WysokinskiWojciech/Praca_Inzynierska/PerformanceLog.txt

Number of Contacts: 8
Number of contact data: 1271
