WysokinskiWojciech/Praca_Inzynierska/Złożenie6.sldasm

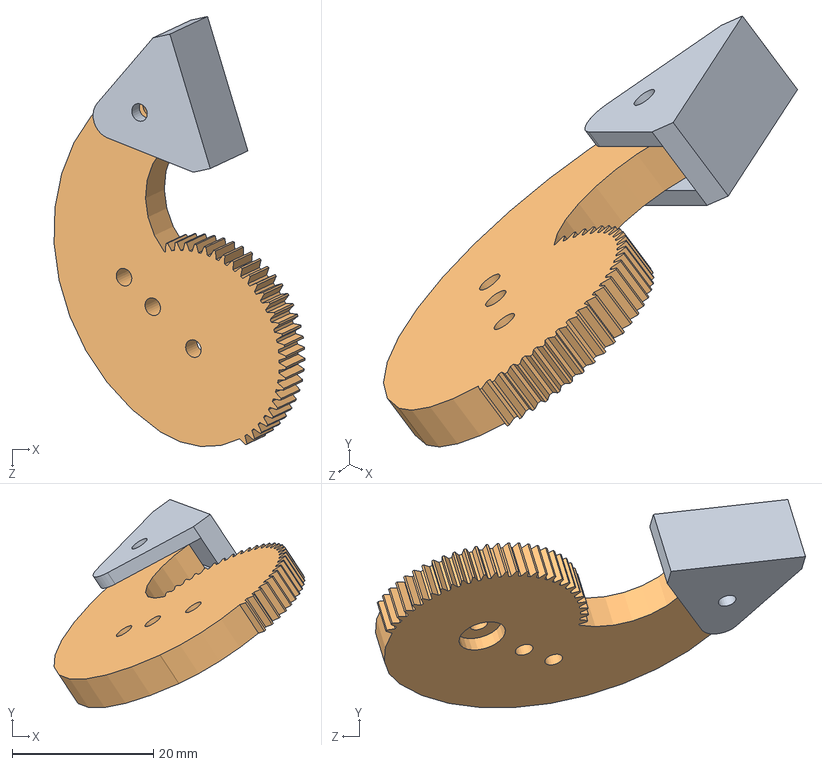
[picture p48: CAD file, 2021-02-26]
Złożenie6.sldasm
35.5 x 29.5 x 60.9 mm
Chwyt
koło_zębate
