WysokinskiWojciech/Praca_Inzynierska/Złożenie7.sldasm

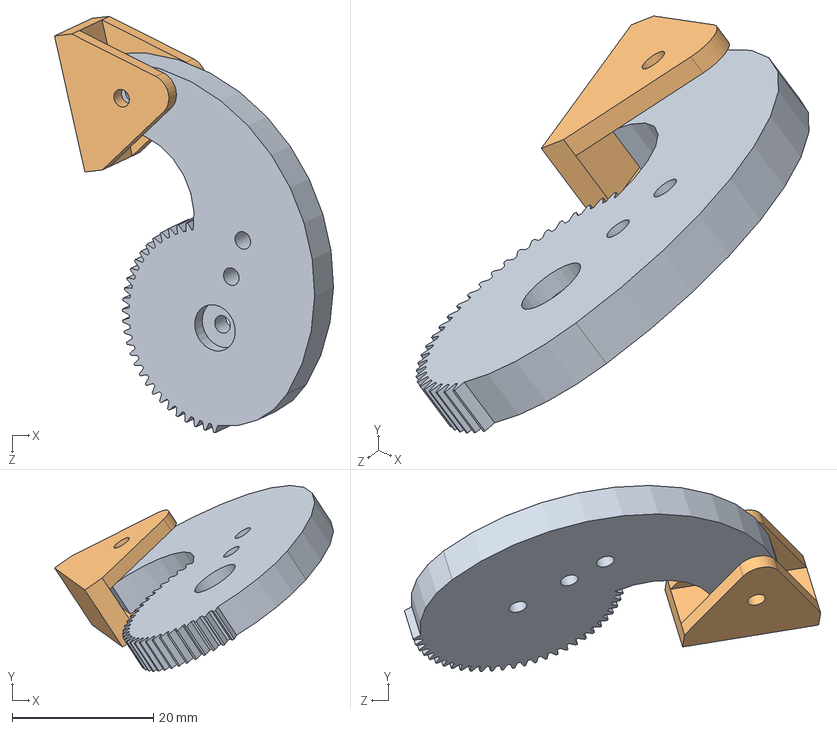
[picture p49: CAD file, 2021-02-26]
Złożenie7.sldasm
39.5 x 26.4 x 59.0 mm
Chwyt
koło_zębate
