WysokinskiWojciech/Praca_Inzynierska/Złożenie3.sldasm

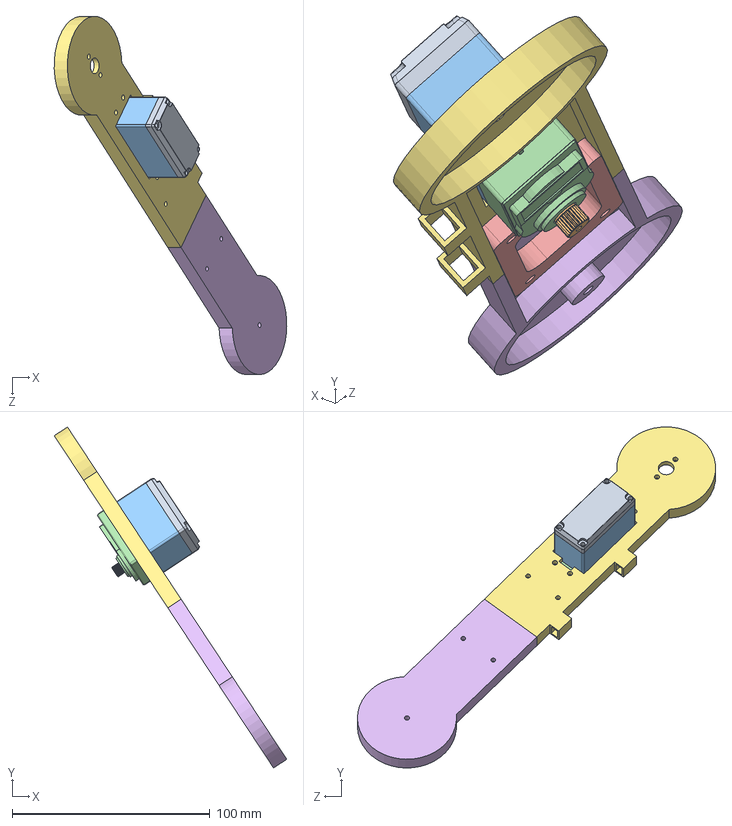
[picture p50: CAD file, 2021-02-26]
Złożenie3.sldasm
117.5 x 172.2 x 180.9 mm
Base
Eje
Medio
plytka
ramie1
ramie
