WysokinskiWojciech/Praca_Inzynierska/Złożenie4.sldasm

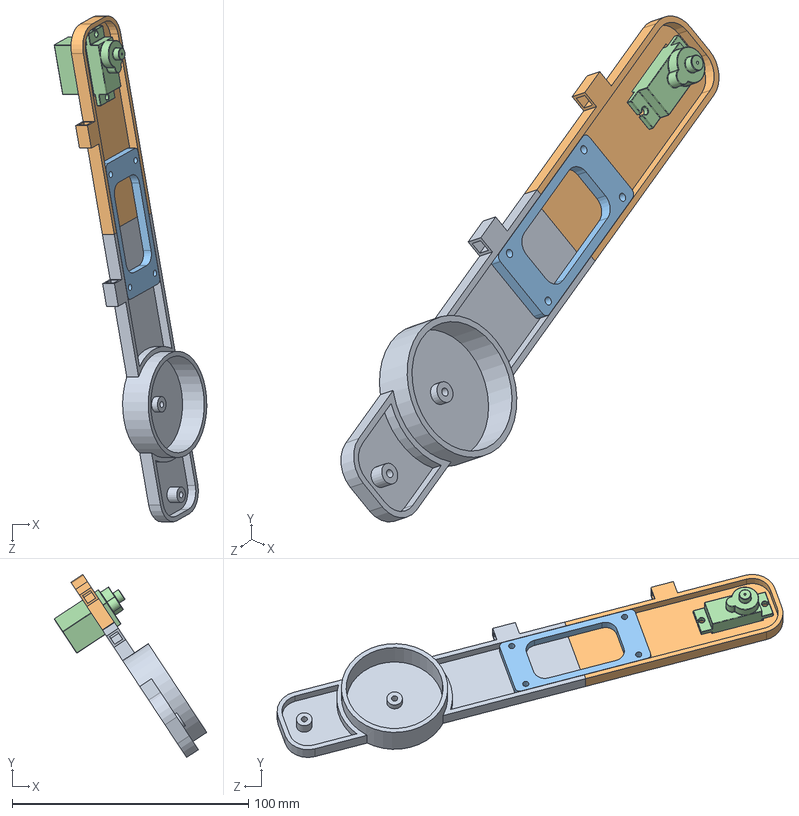
[picture p51: CAD file, 2021-02-26]
Złożenie4.sldasm
64.6 x 77.4 x 213.9 mm
ramie2
ramie21
plytka2
