WysokinskiWojciech/Praca_Inzynierska/Złożenie8.sldasm

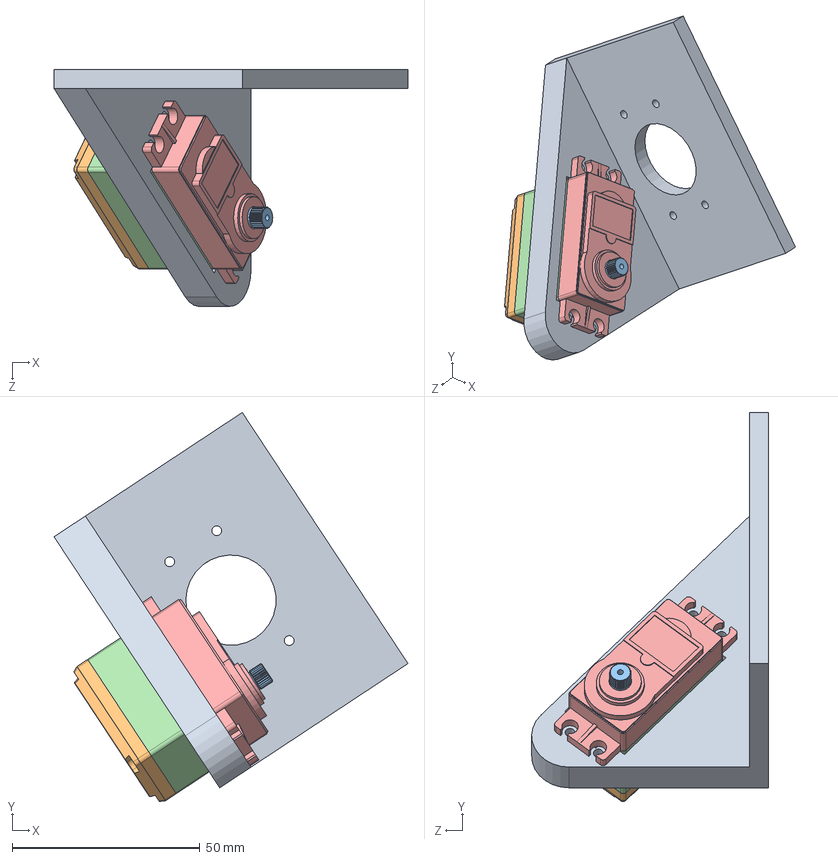
[picture p52: CAD file, 2021-02-26]
Złożenie8.sldasm
94.1 x 103.5 x 63.0 mm
Mocowanie
Base
Eje
Medio
Top
