WysokinskiWojciech/Praca_Inzynierska/MG_996R.SLDASM

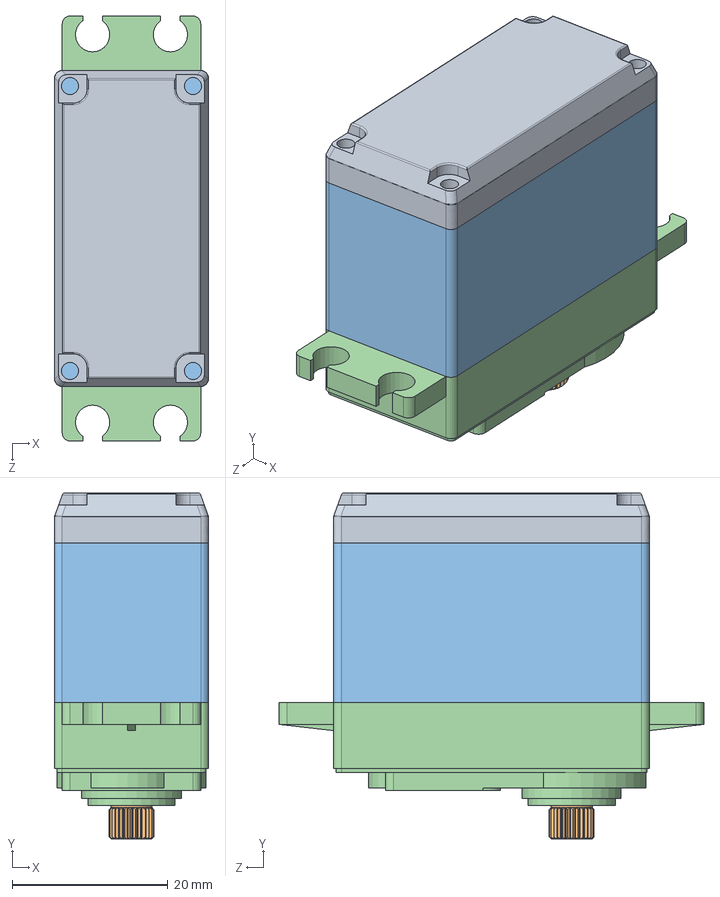
[picture p53: CAD file, 2021-02-26]
MG_996R.SLDASM
19.8 x 44.4 x 54.6 mm
Base
Eje
Medio
Top
