WysokinskiWojciech/Praca_Inzynierska/4 Arm.SLDPRT

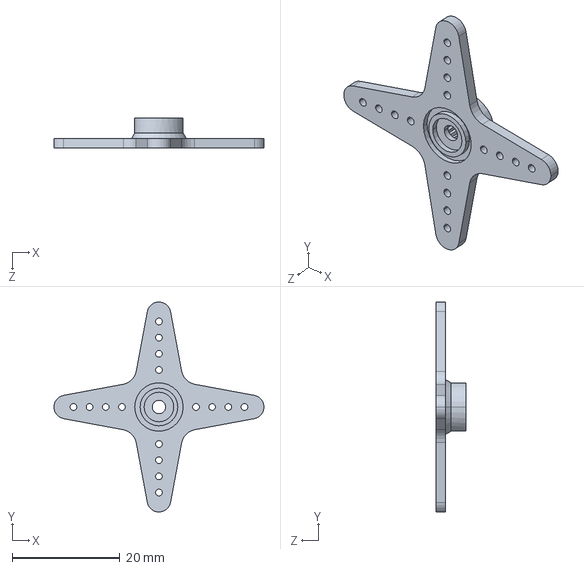
[picture p54: CAD file, 2021-02-26]
4 Arm.SLDPRT
39.0 x 39.0 x 5.50 mm
