WysokinskiWojciech/Praca_Inzynierska/łacznik.SLDPRT

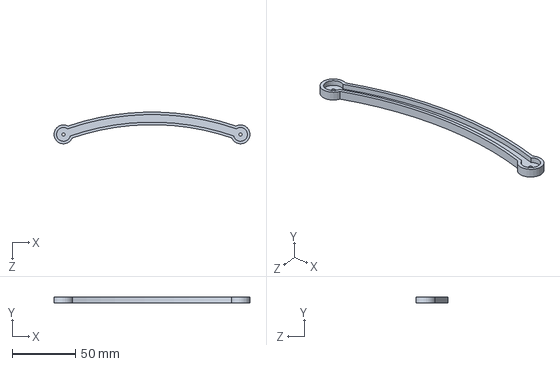
[picture p55: CAD file, 2021-02-26]
łacznik.SLDPRT
155.0 x 5.00 x 25.0 mm
