WysokinskiWojciech/Praca_Inzynierska/Dekiel.SLDPRT

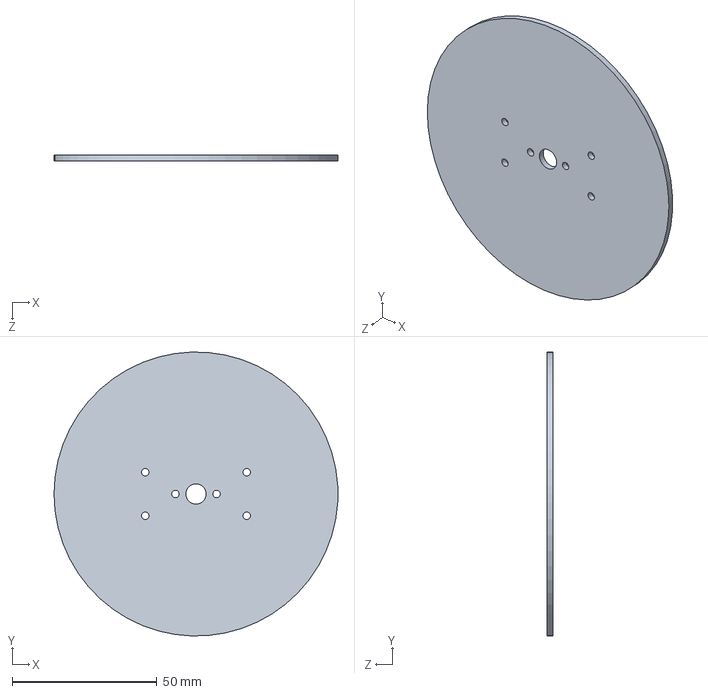
[picture p56: CAD file, 2021-02-26]
Dekiel.SLDPRT
98.0 x 98.0 x 2.00 mm
