WysokinskiWojciech/Praca_Inzynierska/Eje.SLDPRT

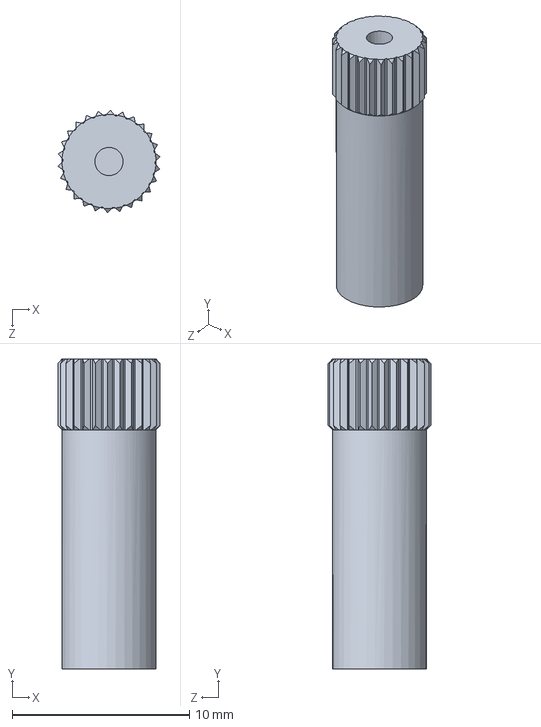
[picture p57: CAD file, 2021-02-26]
Eje.SLDPRT
5.78 x 17.5 x 5.80 mm
