WysokinskiWojciech/Praca_Inzynierska/ramie2.SLDPRT

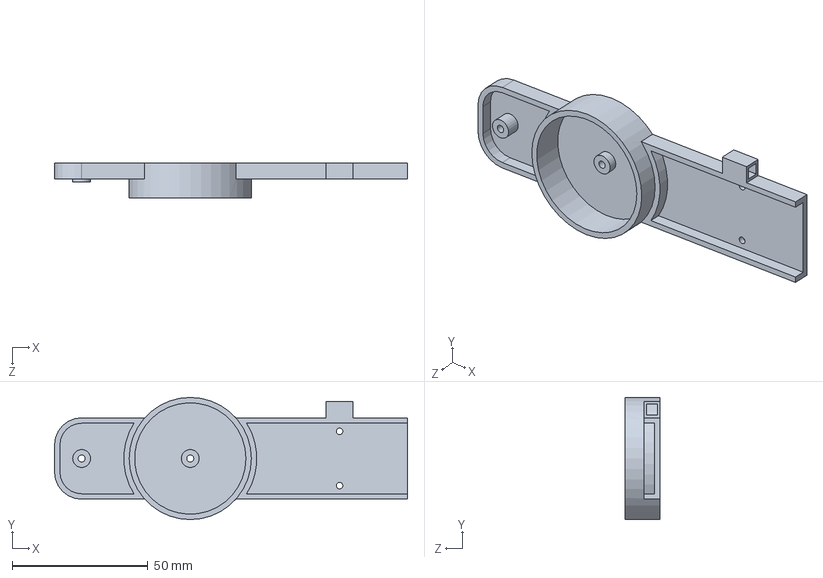
[picture p58: CAD file, 2021-02-26]
ramie2.SLDPRT
130.0 x 45.0 x 13.0 mm
