WysokinskiWojciech/Praca_Inzynierska/ramie21.SLDPRT

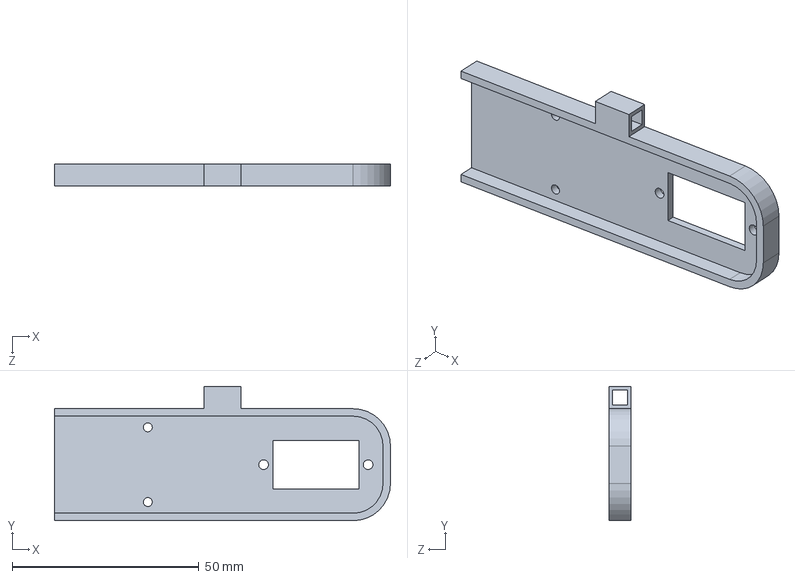
[picture p59: CAD file, 2021-02-26]
ramie21.SLDPRT
90.0 x 36.0 x 6.00 mm
