WysokinskiWojciech/Praca_Inzynierska/podstawa.SLDPRT

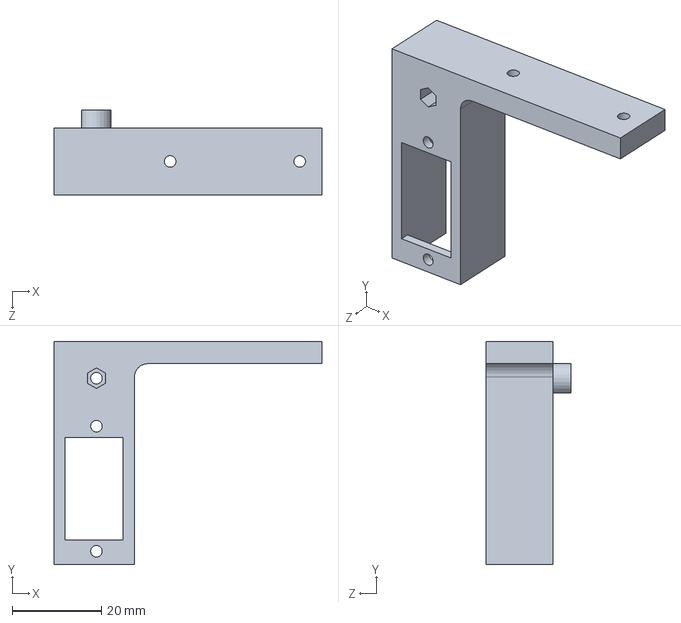
[picture p60: CAD file, 2021-02-26]
podstawa.SLDPRT
60.0 x 50.0 x 19.0 mm
