WysokinskiWojciech/Praca_Inzynierska/111.SLDPRT

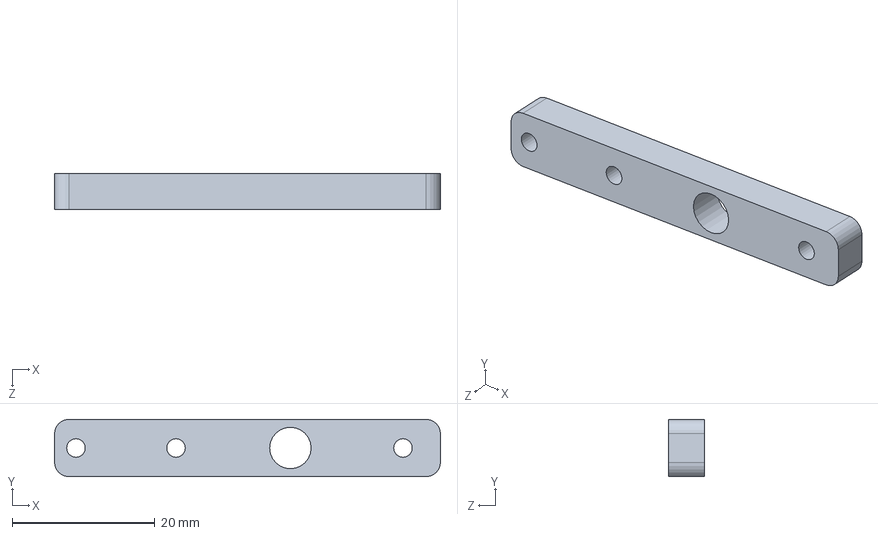
[picture p61: CAD file, 2021-02-26]
111.SLDPRT
54.0 x 8.00 x 5.00 mm
