WysokinskiWojciech/Praca_Inzynierska/msh1.SLDPRT

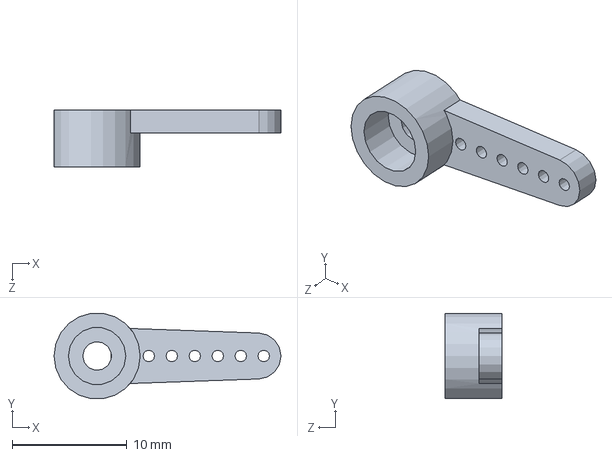
[picture p62: CAD file, 2021-02-26]
msh1.SLDPRT
19.8 x 7.42 x 5.00 mm
