WysokinskiWojciech/Praca_Inzynierska/Chwyt.SLDPRT

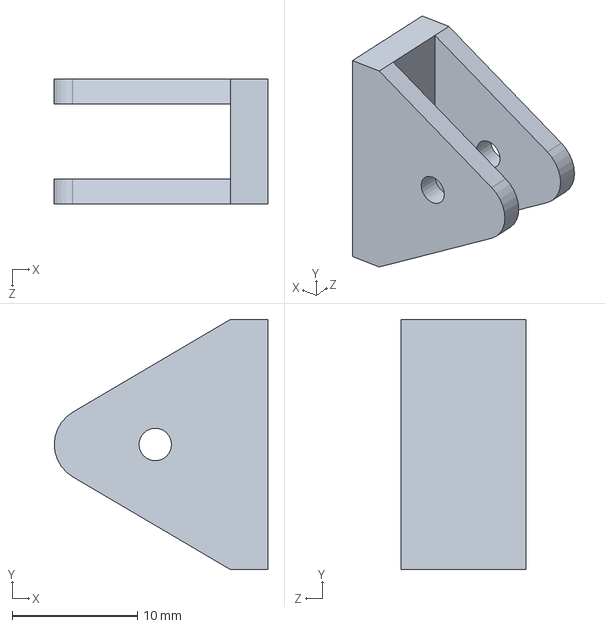
[picture p63: CAD file, 2021-02-26]
Chwyt.SLDPRT
17.1 x 20.0 x 10.0 mm
