WysokinskiWojciech/Praca_Inzynierska/ramie.SLDPRT

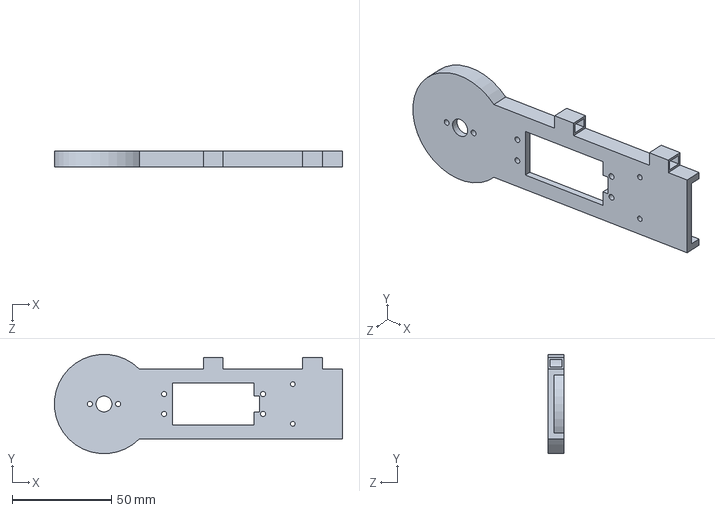
[picture p64: CAD file, 2021-02-26]
ramie.SLDPRT
144.9 x 49.8 x 8.00 mm
