WysokinskiWojciech/Praca_Inzynierska/Top.SLDPRT

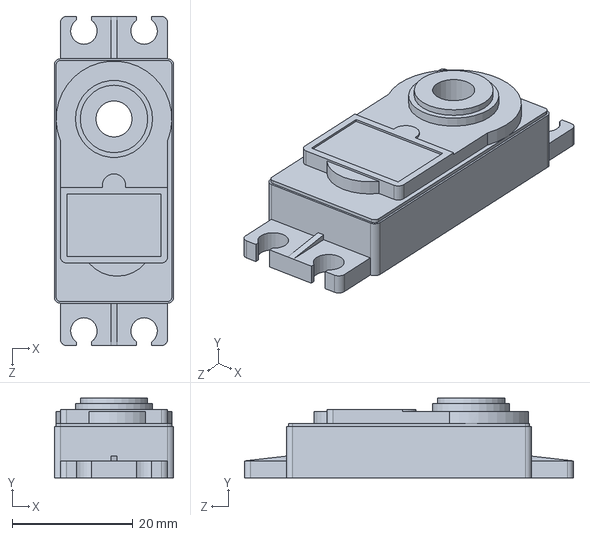
[picture p65: CAD file, 2021-02-26]
Top.SLDPRT
19.8 x 13.2 x 54.6 mm
