WysokinskiWojciech/Praca_Inzynierska/koło_zębate.SLDPRT

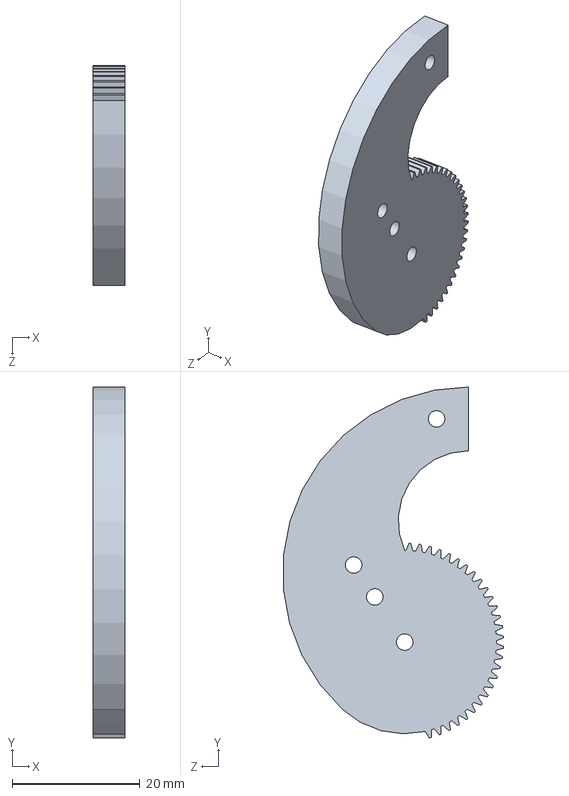
[picture p66: CAD file, 2021-02-26]
koło_zębate.SLDPRT
5.00 x 55.0 x 34.5 mm
