WysokinskiWojciech/Praca_Inzynierska/Orczyk.SLDPRT

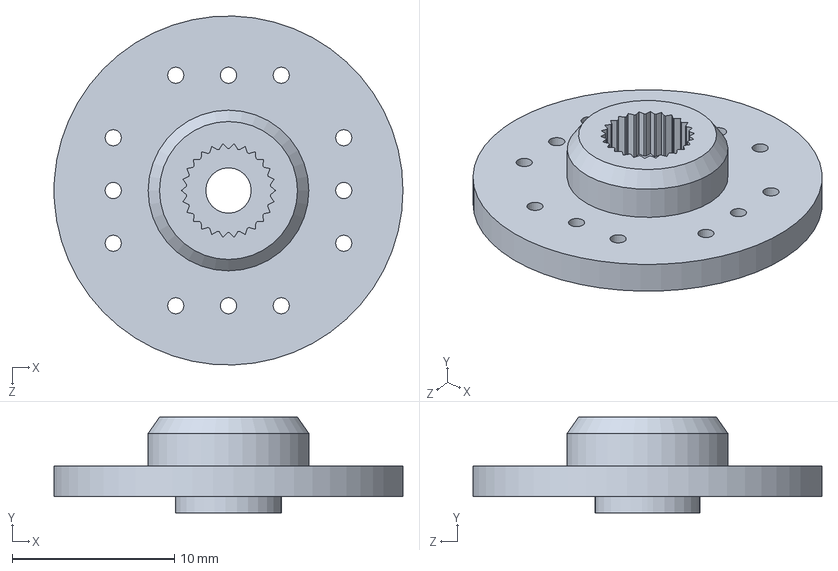
[picture p67: CAD file, 2021-02-26]
Orczyk.SLDPRT
21.5 x 5.90 x 21.5 mm
