WysokinskiWojciech/Praca_Inzynierska/Mocowanie.SLDPRT

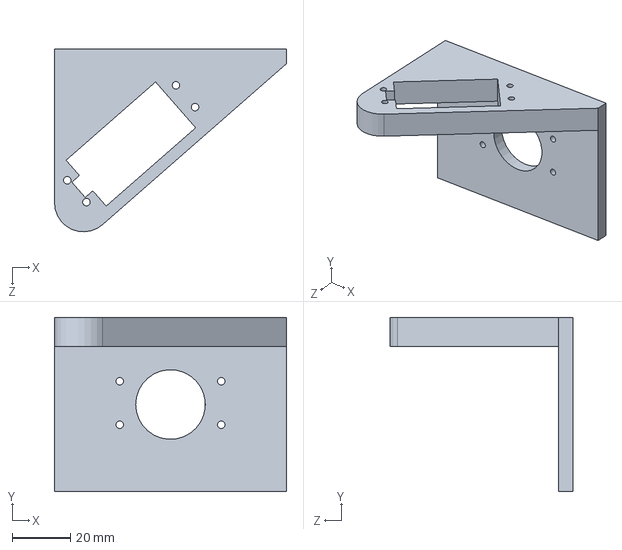
[picture p68: CAD file, 2021-02-26]
Mocowanie.SLDPRT
80.0 x 60.0 x 63.0 mm
