WysokinskiWojciech/Praca_Inzynierska/plytka2.SLDPRT

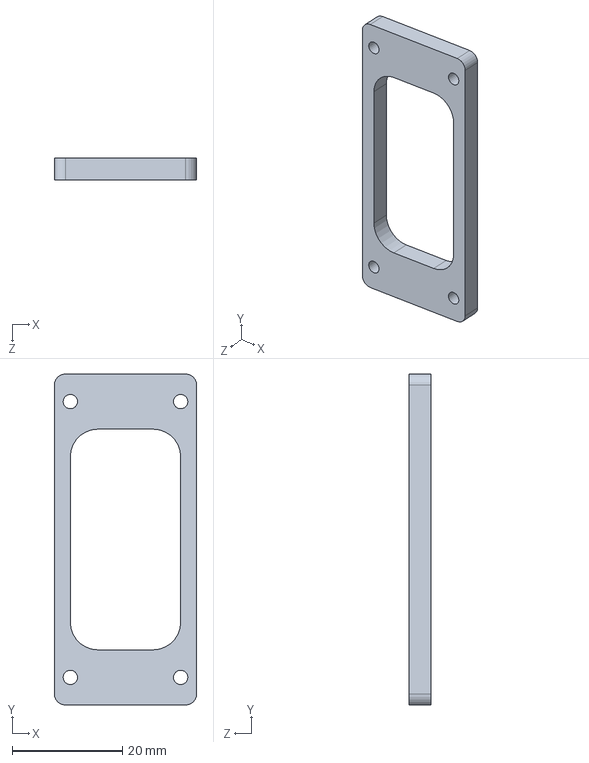
[picture p69: CAD file, 2021-02-26]
plytka2.SLDPRT
25.8 x 60.0 x 4.00 mm
