WysokinskiWojciech/Praca_Inzynierska/msh.SLDPRT

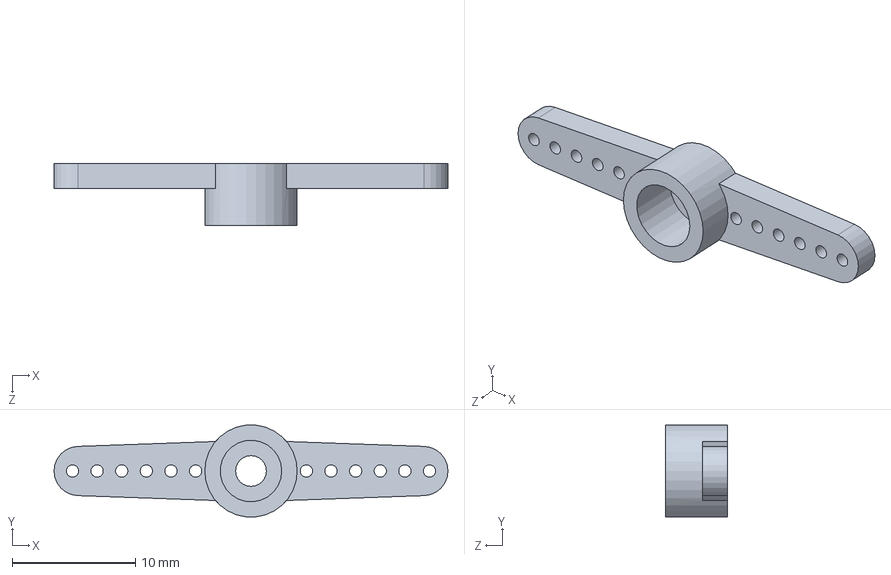
[picture p70: CAD file, 2021-02-26]
msh.SLDPRT
32.0 x 7.46 x 5.00 mm
