WysokinskiWojciech/Praca_Inzynierska/ramie1.SLDPRT

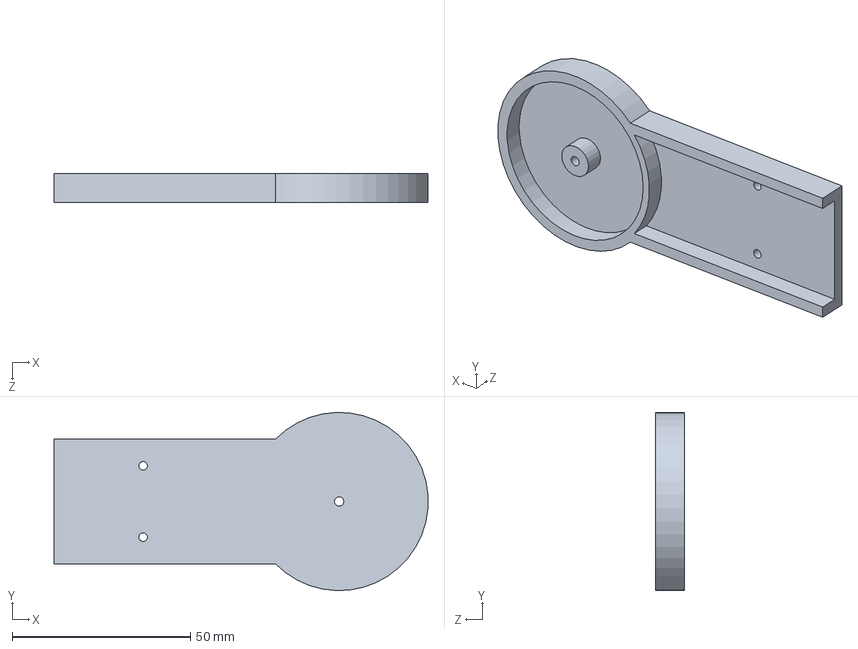
[picture p71: CAD file, 2021-02-26]
ramie1.SLDPRT
104.9 x 50.0 x 8.00 mm
