WysokinskiWojciech/Praca_Inzynierska/Pokrywa.SLDPRT

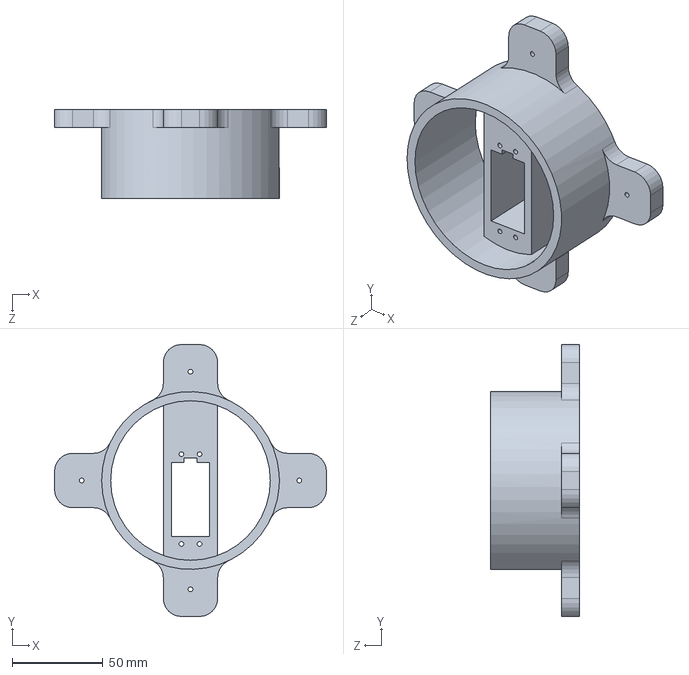
[picture p72: CAD file, 2021-02-26]
Pokrywa.SLDPRT
150.0 x 150.0 x 49.0 mm
