WysokinskiWojciech/Praca_Inzynierska/Medio.SLDPRT

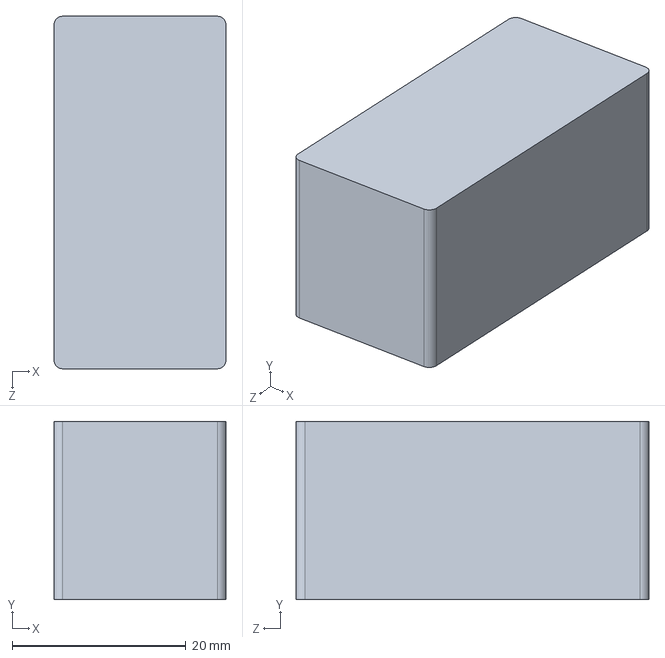
[picture p73: CAD file, 2021-02-26]
Medio.SLDPRT
19.8 x 20.5 x 40.6 mm
