WysokinskiWojciech/Praca_Inzynierska/servo TOWER PRO 9g SG90.SLDPRT

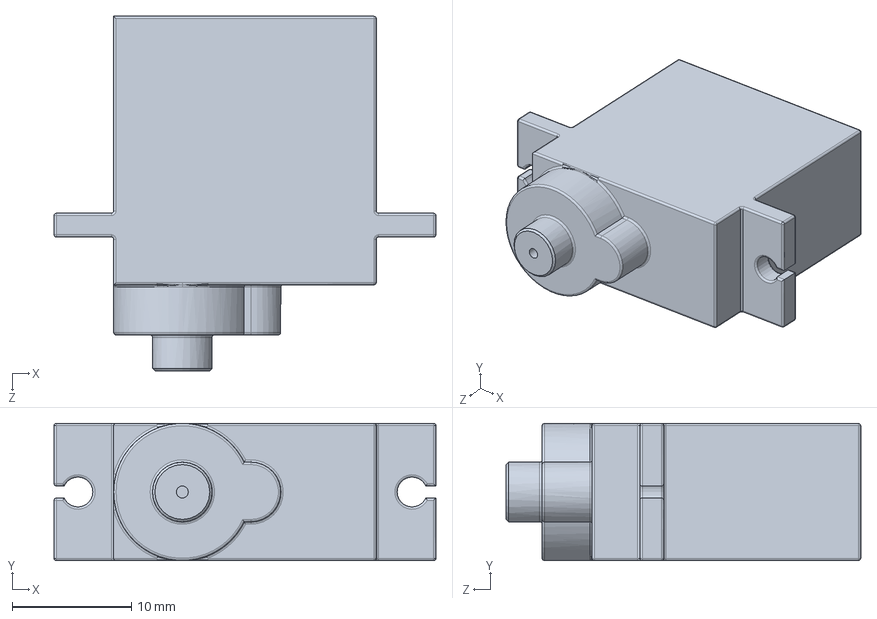
[picture p74: CAD file, 2021-02-26]
servo TOWER PRO 9g SG90.SLDPRT
32.0 x 11.5 x 29.7 mm
