WysokinskiWojciech/Praca_Inzynierska/Base.SLDPRT

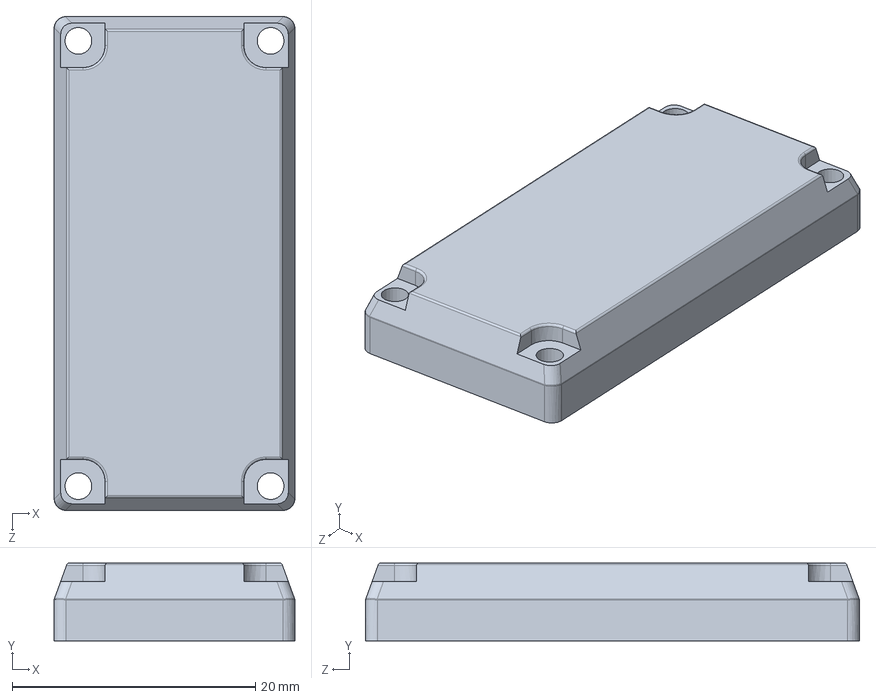
[picture p75: CAD file, 2021-02-26]
Base.SLDPRT
19.8 x 6.40 x 40.6 mm
