WysokinskiWojciech/Praca_Inzynierska/plytka.SLDPRT

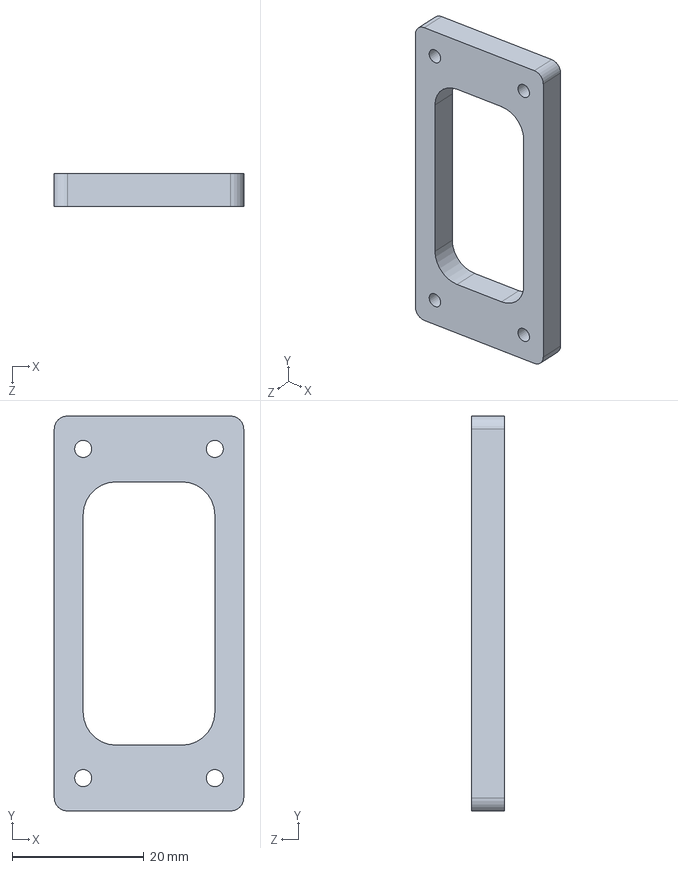
[picture p76: CAD file, 2021-02-26]
plytka.SLDPRT
28.8 x 60.0 x 5.00 mm
