WysokinskiWojciech/Praca_Inzynierska/(list of files, cad)

Other CAD files:
hex screw gradeab_din.sldprt
hex thin nut chamfered gradeab_din.sldprt
pan head cross recess screw_din.sldprt
plain washer 6902 type abc_din.sldprt
